gilbertyap/REACH_Robot/KiCad Files/RobotPcb.png

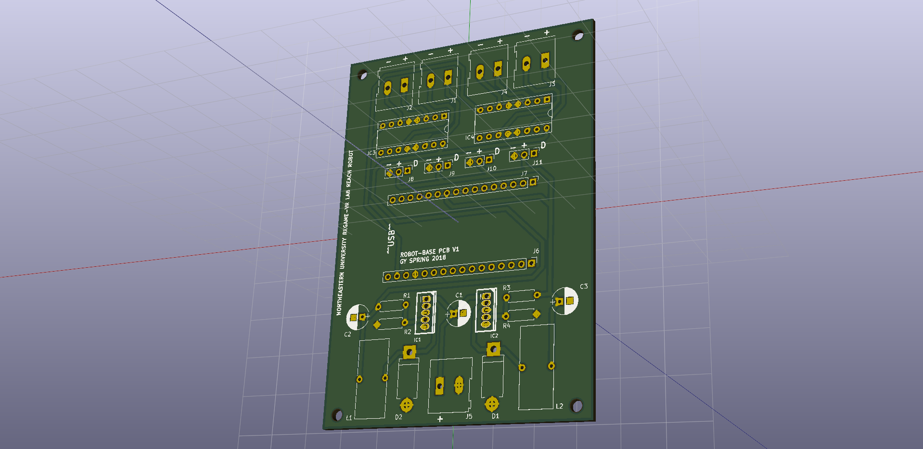
KiCad Files/RobotPcb.png
