gilbertyap/REACH_Robot/LeapCalibrate/test_limits.txt

118.657051086
-210.298599243
386.301147461
59.1329040527
156.813812256
-90.3006362915
