gilbertyap/REACH_Robot/KiCad Files/Schematic.pdf

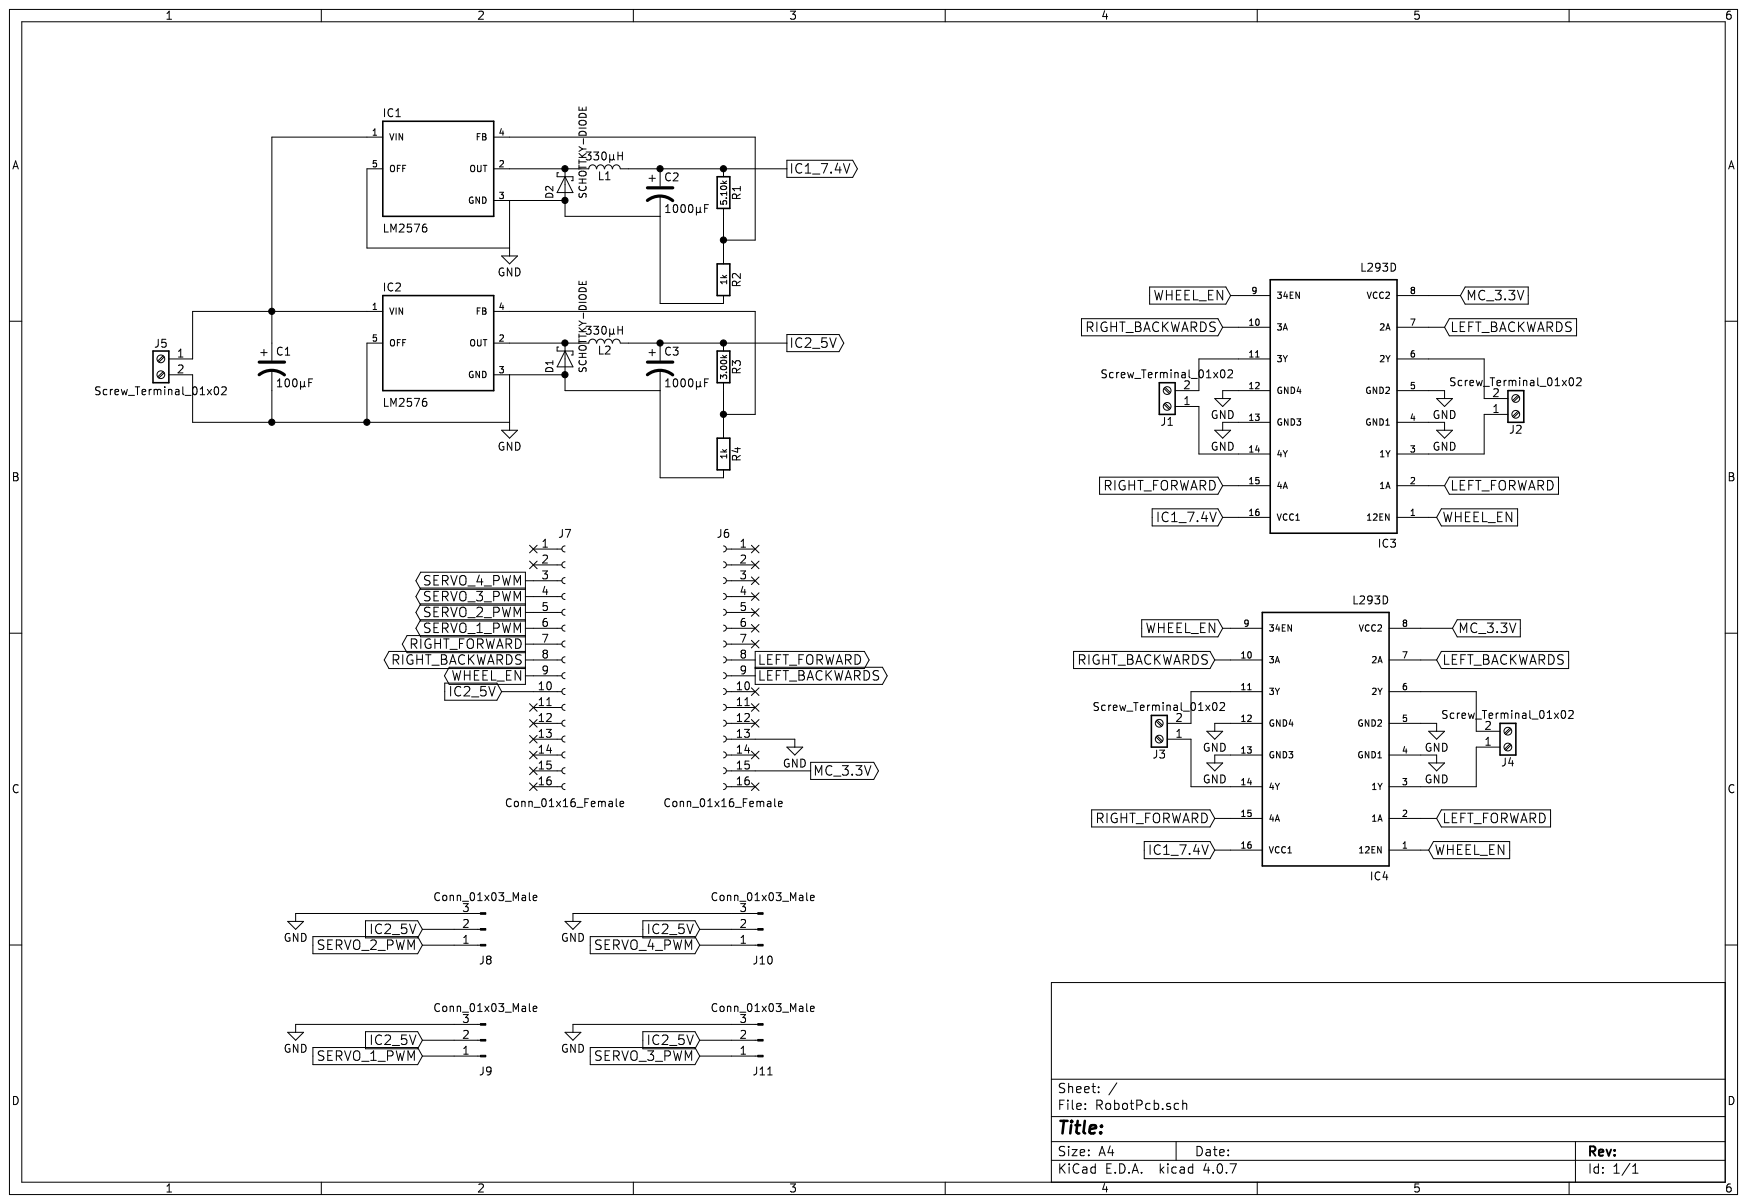
[picture p2: page 1]
