gilbertyap/REACH_Robot/KiCad Files/RobotPcb.kicad_pcb

## KiCad design KiCad Files/RobotPcb.kicad_pcb (2018-04-27)

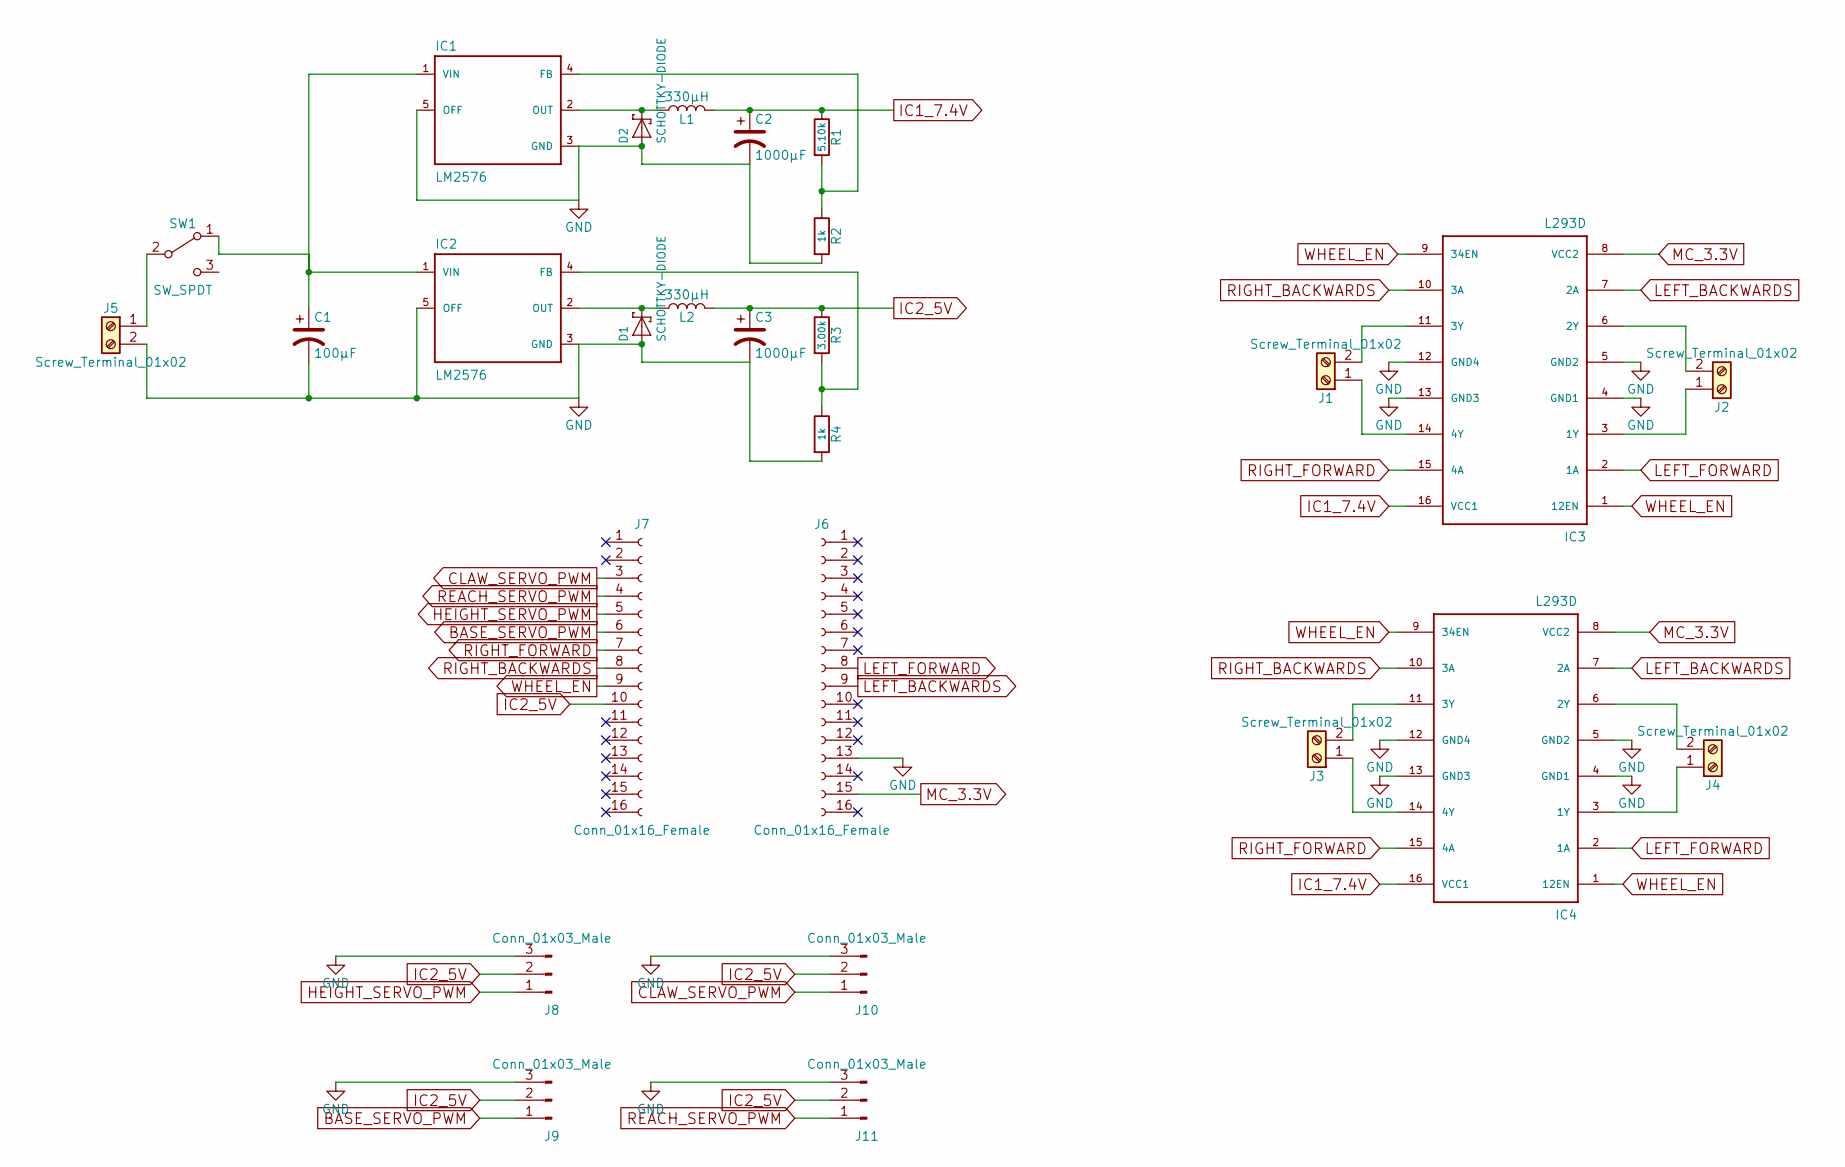
[picture p3: schematic RobotPcb.sch]

Parts:
C1: 100μF; CP_Radial_D6.3mm_P2.50mm
C2, C3: 1000μF; CP_Radial_D6.3mm_P2.50mm
D1, D2: SCHOTTKY-DIODE; D_DO-201AD_P12.70mm_Horizontal
IC1, IC2: LM2576; TO-220-5
IC3, IC4: L293D; DIP-16_W7.62mm_Socket
J1, J2, J3, J4, J5: Screw_Terminal_01x02; TerminalBlock_Altech_AK300-2_P5.00mm
J6, J7: Conn_01x16_Female; Socket_Strip_Straight_1x16_Pitch2.54mm
J8, J9, J10, J11: Conn_01x03_Male; Pin_Header_Straight_1x03_Pitch2.54mm
L1, L2: 330μH; L_Toroid_Vertical_L19.1mm_W8.1mm_P7.10mm_Bourns_5700
R1: 5.10k; R_Axial_DIN0207_L6.3mm_D2.5mm_P7.62mm_Horizontal
R2, R4: 1k; R_Axial_DIN0207_L6.3mm_D2.5mm_P7.62mm_Horizontal
R3: 3.00k; R_Axial_DIN0207_L6.3mm_D2.5mm_P7.62mm_Horizontal
SW1: SW_SPDT; L102021ML04Q_SPDT

Connections:
BASE_SERVO_PWM: J7.6, J9.1
CLAW_SERVO_PWM: J7.3, J10.1
GND: C1.2, C2.2, C3.2, D1.2, D2.2, IC1.3 (GND), IC1.5 (OFF), IC2.3 (GND), IC2.5 (OFF), IC3.4 (GND1), IC3.5 (GND2), IC3.12 (GND4), IC3.13 (GND3), IC4.4 (GND1), IC4.5 (GND2), IC4.12 (GND4), IC4.13 (GND3), J5.2, J6.13, J8.3, J9.3, J10.3, J11.3, R2.2, R4.2
HEIGHT_SERVO_PWM: J7.5, J8.1
IC1_7.4V: C2.1, IC3.16 (VCC1), IC4.16 (VCC1), L1.2, R1.1
IC2_5V: C3.1, J7.10, J8.2, J9.2, J10.2, J11.2, L2.2, R3.1
LEFT_BACKWARDS: IC3.7 (2A), IC4.7 (2A), J6.9
LEFT_FORWARD: IC3.2 (1A), IC4.2 (1A), J6.8
MC_3.3V: IC3.8 (VCC2), IC4.8 (VCC2), J6.15
unnamed: C1.1, IC1.1 (VIN), IC2.1 (VIN), SW1.1 (A)
unnamed: D1.1, IC2.2 (OUT), L2.1
unnamed: D2.1, IC1.2 (OUT), L1.1
unnamed: IC1.4 (FB), R1.2, R2.1
unnamed: IC2.4 (FB), R3.2, R4.1
unnamed: IC3.3 (1Y), J2.1
unnamed: IC3.6 (2Y), J2.2
unnamed: IC3.11 (3Y), J1.2
unnamed: IC3.14 (4Y), J1.1
unnamed: IC4.3 (1Y), J4.1
unnamed: IC4.6 (2Y), J4.2
unnamed: IC4.11 (3Y), J3.2
unnamed: IC4.14 (4Y), J3.1
unnamed: J5.1, SW1.2 (B)
REACH_SERVO_PWM: J7.4, J11.1
RIGHT_BACKWARDS: IC3.10 (3A), IC4.10 (3A), J7.8
RIGHT_FORWARD: IC3.15 (4A), IC4.15 (4A), J7.7
WHEEL_EN: IC3.1 (12EN), IC3.9 (34EN), IC4.1 (12EN), IC4.9 (34EN), J7.9

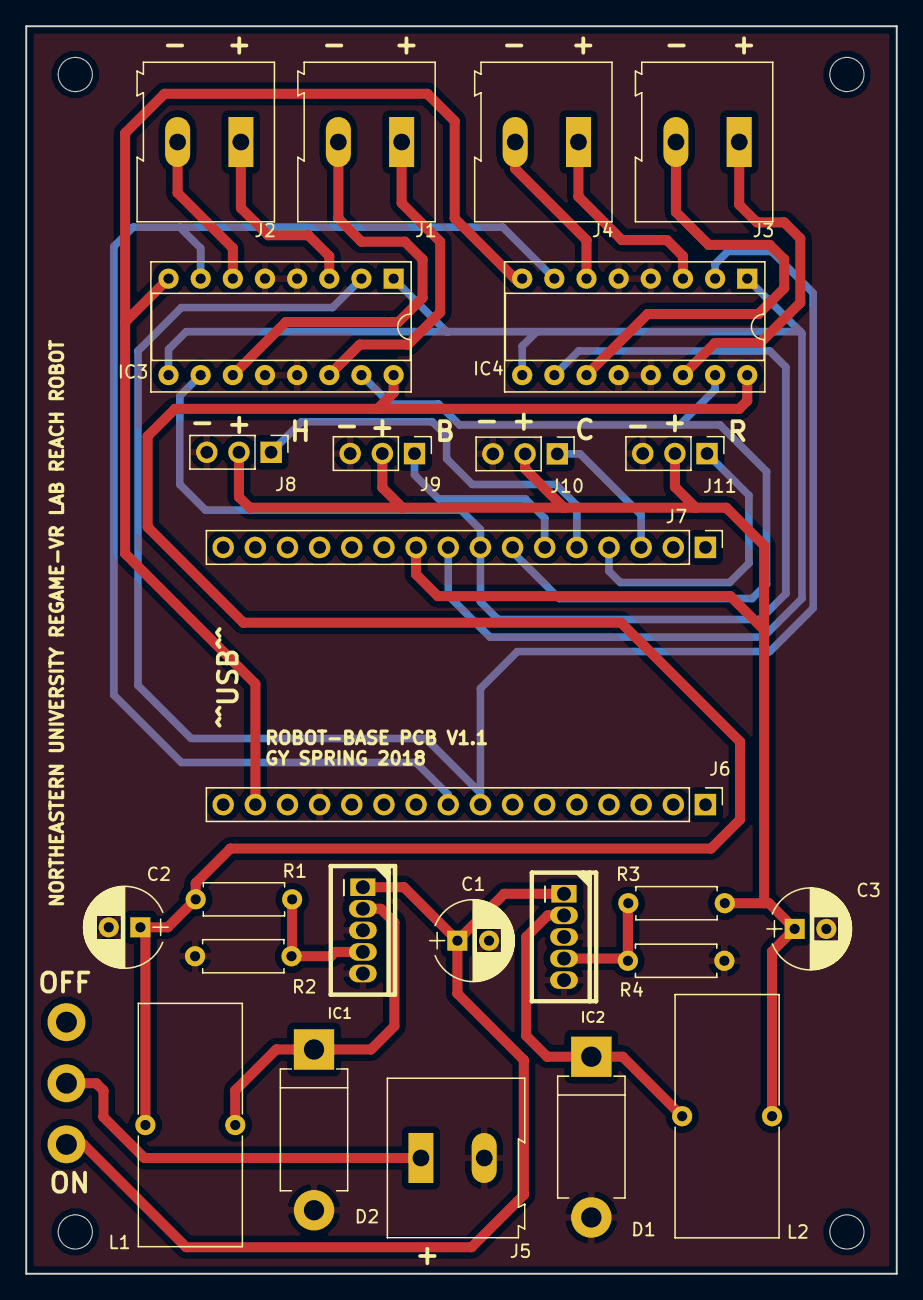
[picture p4: board RobotPcb.kicad_pcb from above]

Board: 2 copper layers, 68.8 x 98.6 mm, 27 parts (0 on the bottom side), 27 nets.
