gilbertyap/REACH_Robot/(commit log)

2018-01-19 Wireless code for arm and computer-side added
2018-01-23 Fixed tranceiver model number
    [Base_Joystick.ino]
2018-02-04 Fixes to frame gathering and hand position data
    [Reach.py]
2018-02-08 Joystick transmission, timers added
2018-02-21 main not working, check new branch for fix
    [Base_Joystick.ino, Reach.py, main.ino]
2018-02-21 Fixed averaging issue, more comments
    [Reach.py, servoLimit.py]
2018-02-22 Base motor control, scheduler, joystick finishes
2018-03-30 Added preliminary schematic files (Immanuel init)
    [RobotPcb.kicad_pcb, RobotPcb.sch]
2018-04-11 PCB Files added
    [RobotPcb-B.CrtYd.gbr, RobotPcb-B.Cu.gbl, RobotPcb-B.Mask.gbs, RobotPcb-B.SilkS.gbo, RobotPcb-Edge.Cuts.gm1, RobotPcb-F.CrtYd.gbr, RobotPcb-F.Cu.gtl, RobotPcb-F.Mask.gts]
2018-04-27 Fixed PCBs
    PCB v1.1
    Added schematic PDF, updated pinout for PCB
    [RobotPcb-B.CrtYd.gbr, RobotPcb-B.Cu.gbl, RobotPcb-B.Mask.gbs, RobotPcb-B.SilkS.gbo, RobotPcb-Edge.Cuts.gm1, RobotPcb-F.CrtYd.gbr, RobotPcb-F.Cu.gtl, RobotPcb-F.Mask.gts]
2018-04-27 Added KiCad folder description
